raptortest/IoT-Water-Monitoring/3 picture/32.jpg

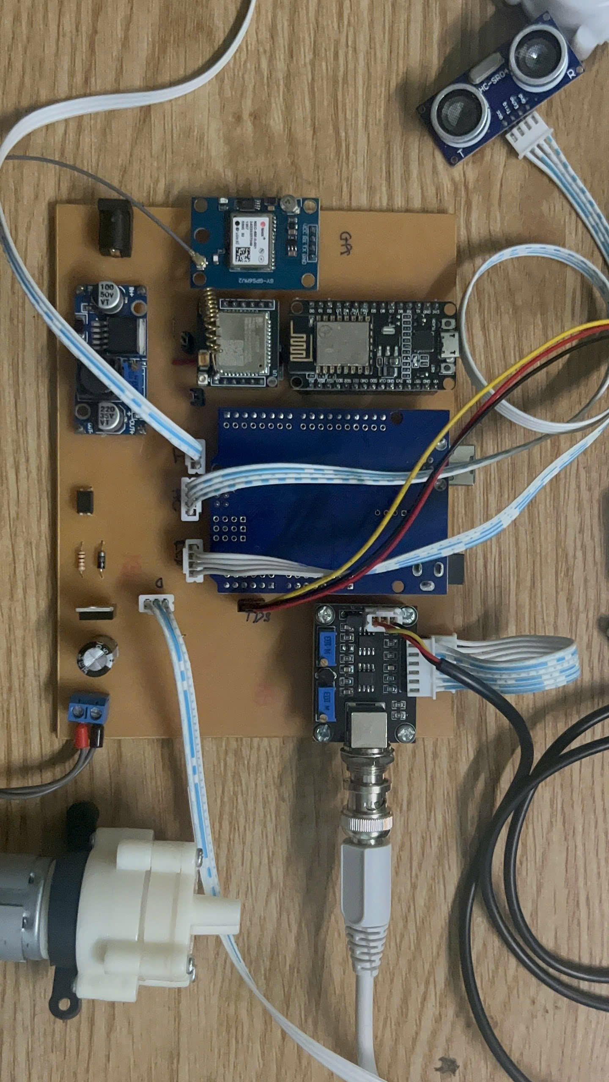
3 picture/32.jpg
