raptortest/IoT-Water-Monitoring/3 picture/54.jpg

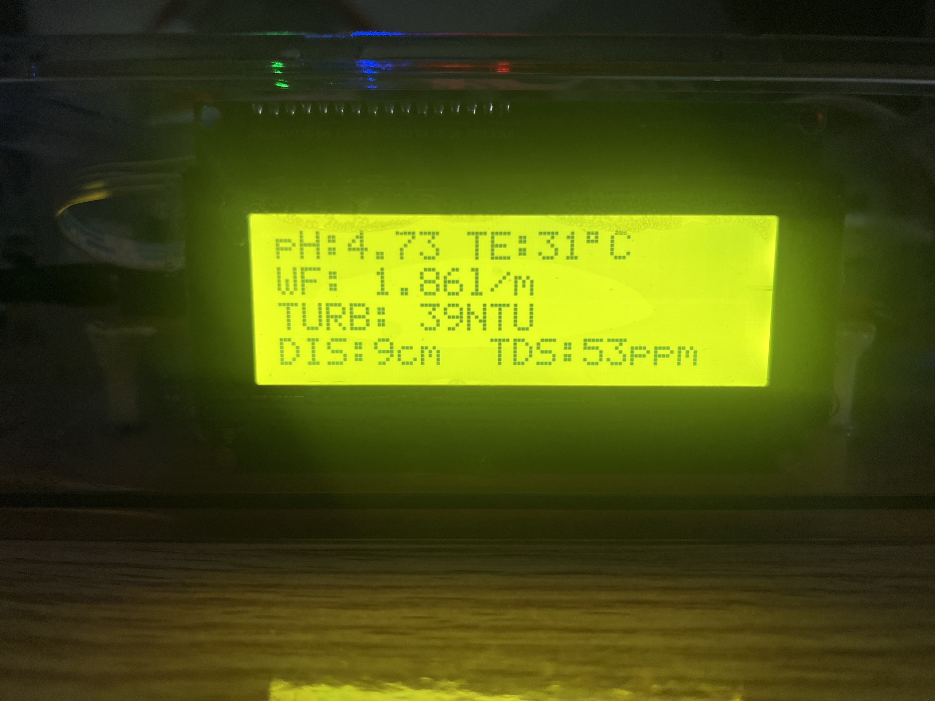
3 picture/54.jpg
