raptortest/IoT-Water-Monitoring/README.md

# 📡 IoT-Based Water Resource Monitoring System

🎓 **Graduation Thesis – International University - VNU HCMC**  
👨‍🎓 Student: Nguyễn Trung Tín – ID: EEACIU19063  
👨‍🏫 Advisor: Dr. Vương Quốc Bảo  
📅 Year: 2025  

---

## 📘 Overview
This project develops an IoT-based system for real-time monitoring of water quality using multiple sensors (pH, TDS, turbidity, temperature, flow, GPS) integrated with Arduino and ESP8266. It sends alerts via the Blynk app and SMS using a 4G A7682S module.

---

## 🔧 Technologies Used
- Arduino UNO, ESP8266, A7682S 4G LTE Module
- Sensors: pH, TDS, Turbidity, DS18B20 Temperature, YF-S401 Flow, GPS
- Blynk IoT Platform
- Proteus Design Suite (for circuit simulation)
- C/C++ (Arduino IDE)

---

## 📂 Folder Structure
- `/code`: Arduino and ESP code
- `/thesis`: Thesis report and presentation
- `/images`: Prototype photos, LCD outputs, Blynk screenshots
- `/proteus`: Circuit simulation files
- `/data`: Sensor calibration and test data

---

## 📲 Features
- Real-time monitoring via Blynk app
- SMS alerts when thresholds exceeded
- Location tracking via GPS
- Flow rate calculation and pH adjustment logic
- Proteus circuit simulation provided

---

## 📸 Screenshots

---

## 🧪 Results
The system has been tested in various water conditions (acidic, neutral, alkaline), showing reliable and accurate sensor readings with timely alerts.

---

## 📈 Future Improvements
- Integrate AI to classify water quality (clean vs polluted)
- Improve sensor calibration accuracy
- Add solar power module for remote deployment

---

## 📜 License
This project is licensed under the MIT License.
