raptortest/IoT-Water-Monitoring/3 picture/1.jpg

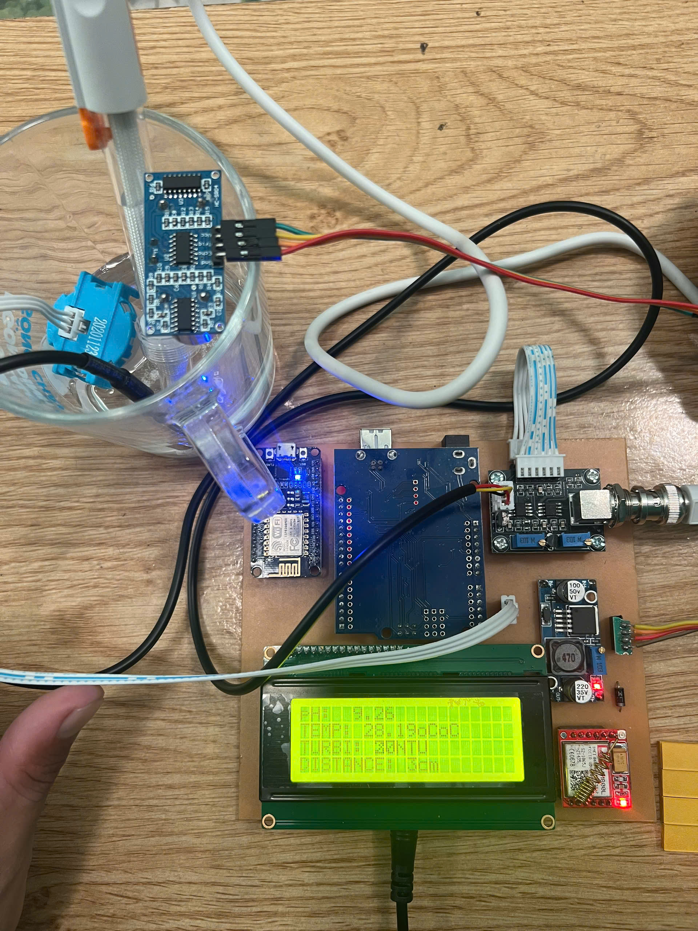
3 picture/1.jpg
