raptortest/IoT-Water-Monitoring/3 picture/2.jpg

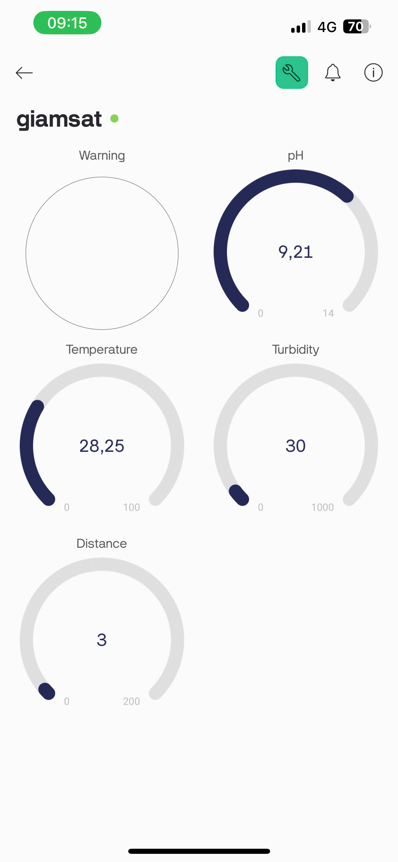
3 picture/2.jpg
