raptortest/IoT-Water-Monitoring/3 picture/3.jpg

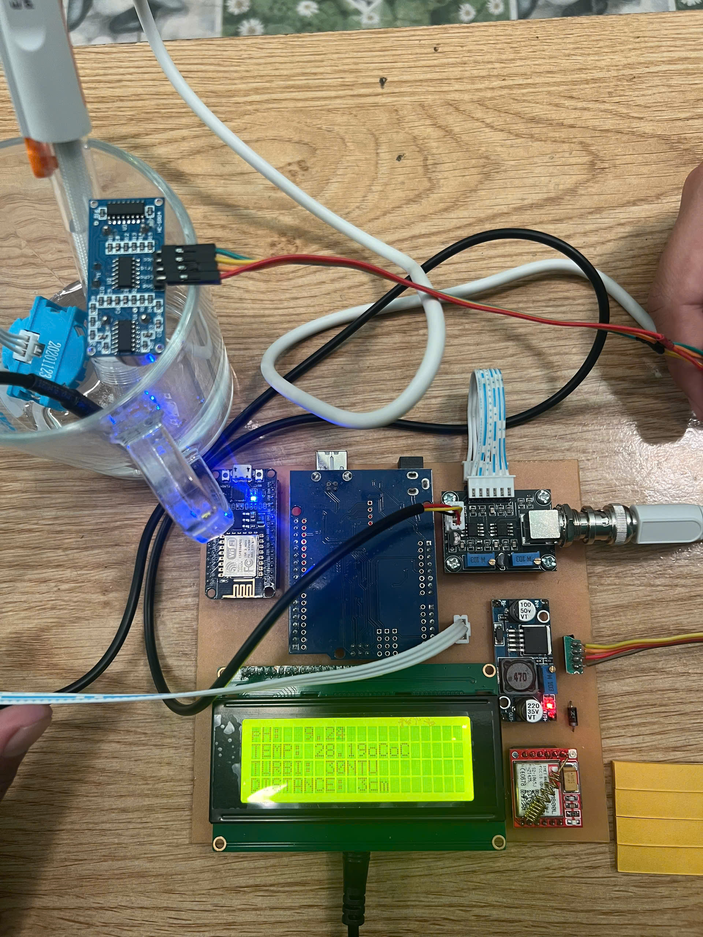
3 picture/3.jpg
