raptortest/IoT-Water-Monitoring/3 picture/4.jpg

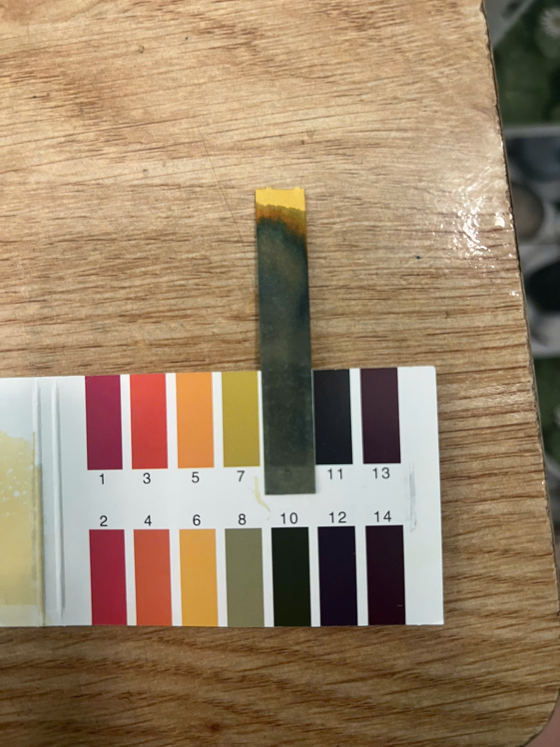
3 picture/4.jpg
