raptortest/IoT-Water-Monitoring/3 picture/5.jpg

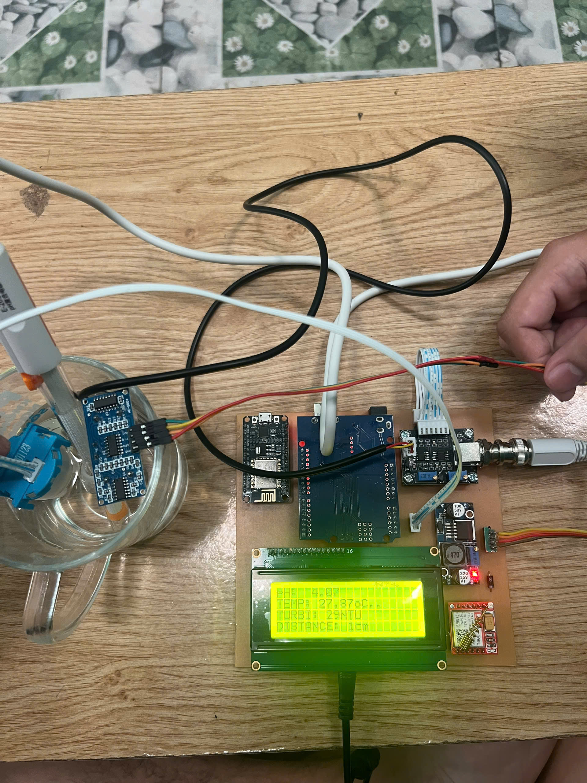
3 picture/5.jpg
