raptortest/IoT-Water-Monitoring/3 picture/6.jpg

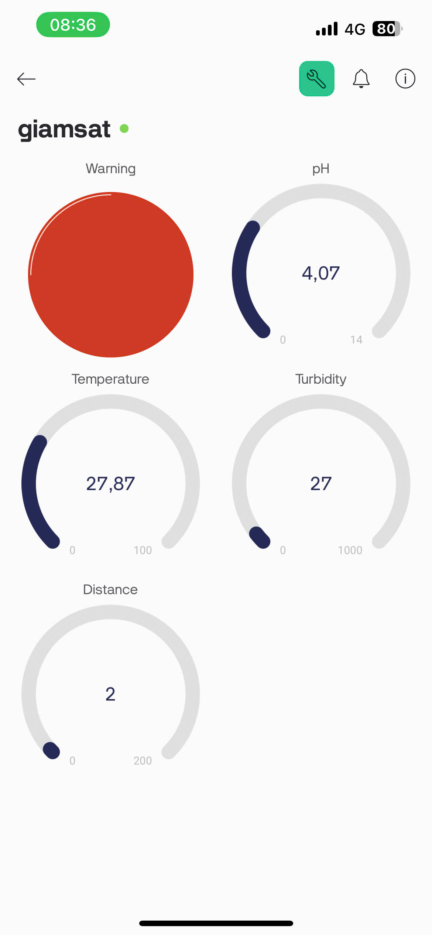
3 picture/6.jpg
