raptortest/IoT-Water-Monitoring/3 picture/7.jpg

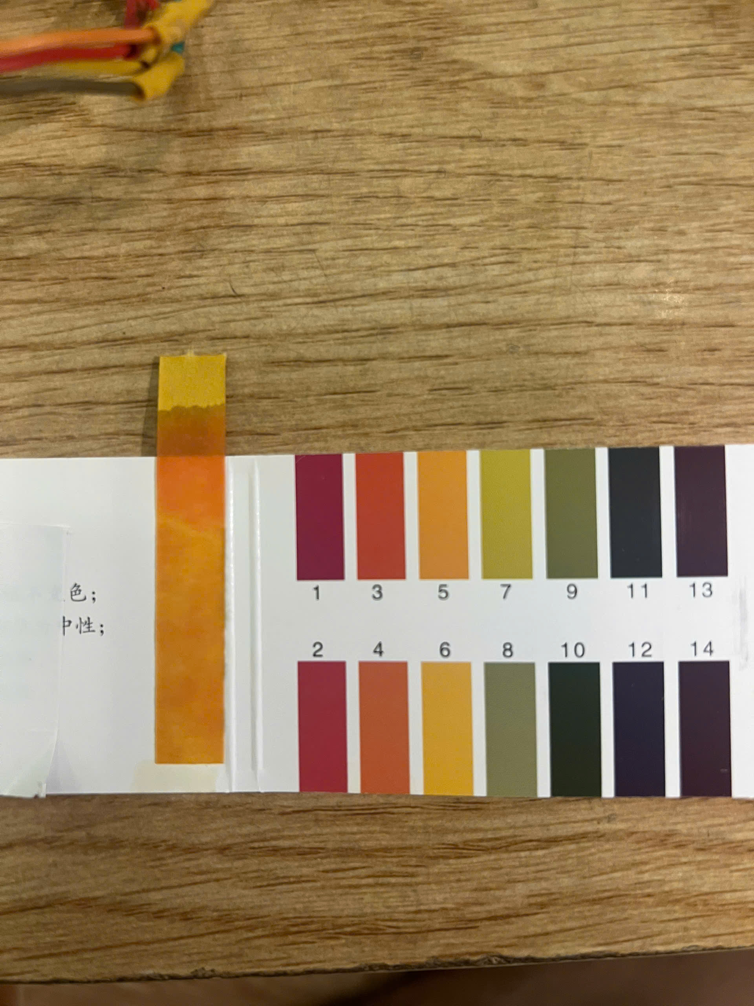
3 picture/7.jpg
