raptortest/IoT-Water-Monitoring/3 picture/8.jpg

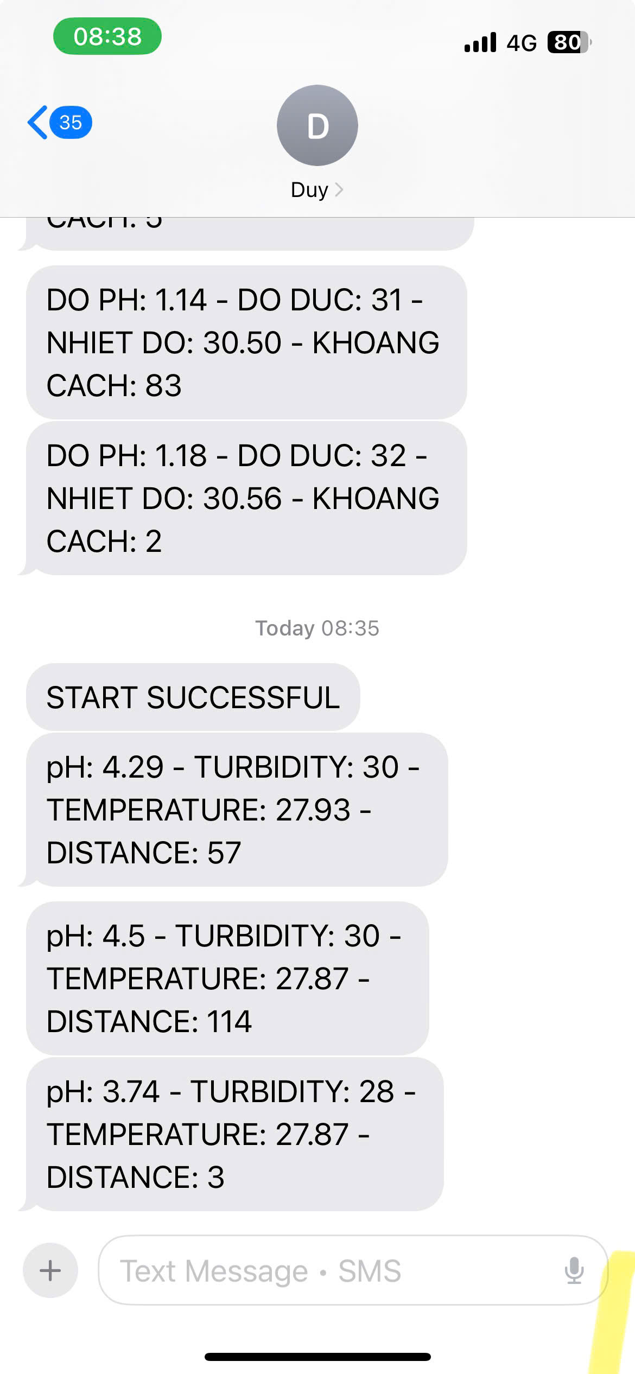
3 picture/8.jpg
