raptortest/IoT-Water-Monitoring/3 picture/9.jpg

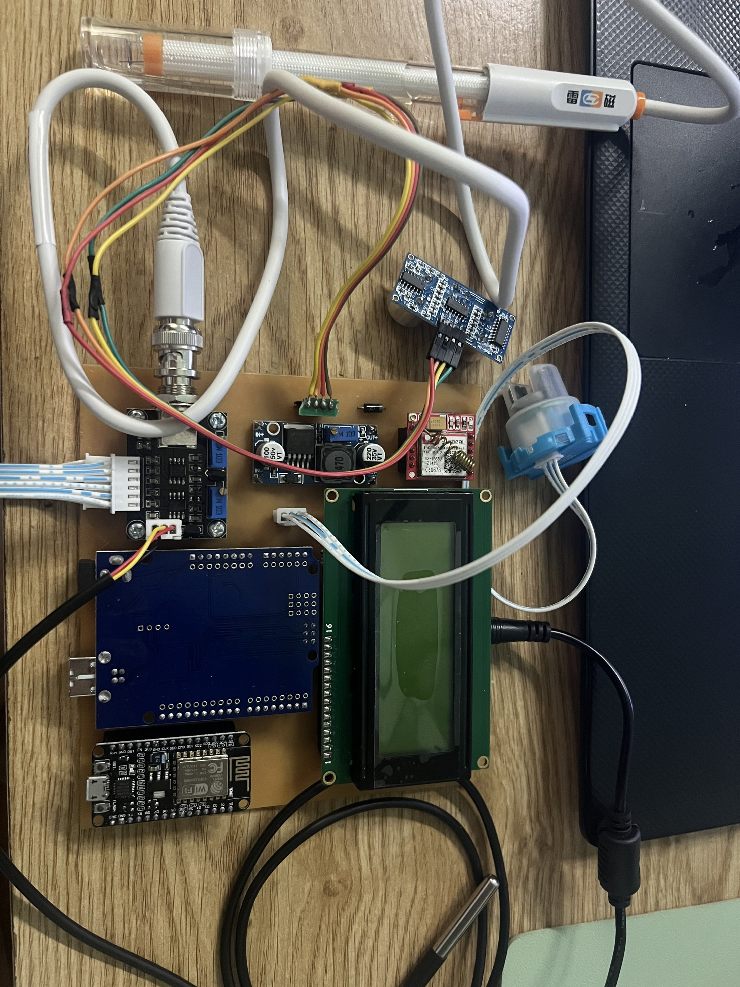
3 picture/9.jpg
