raptortest/IoT-Water-Monitoring/3 picture/10.jpg

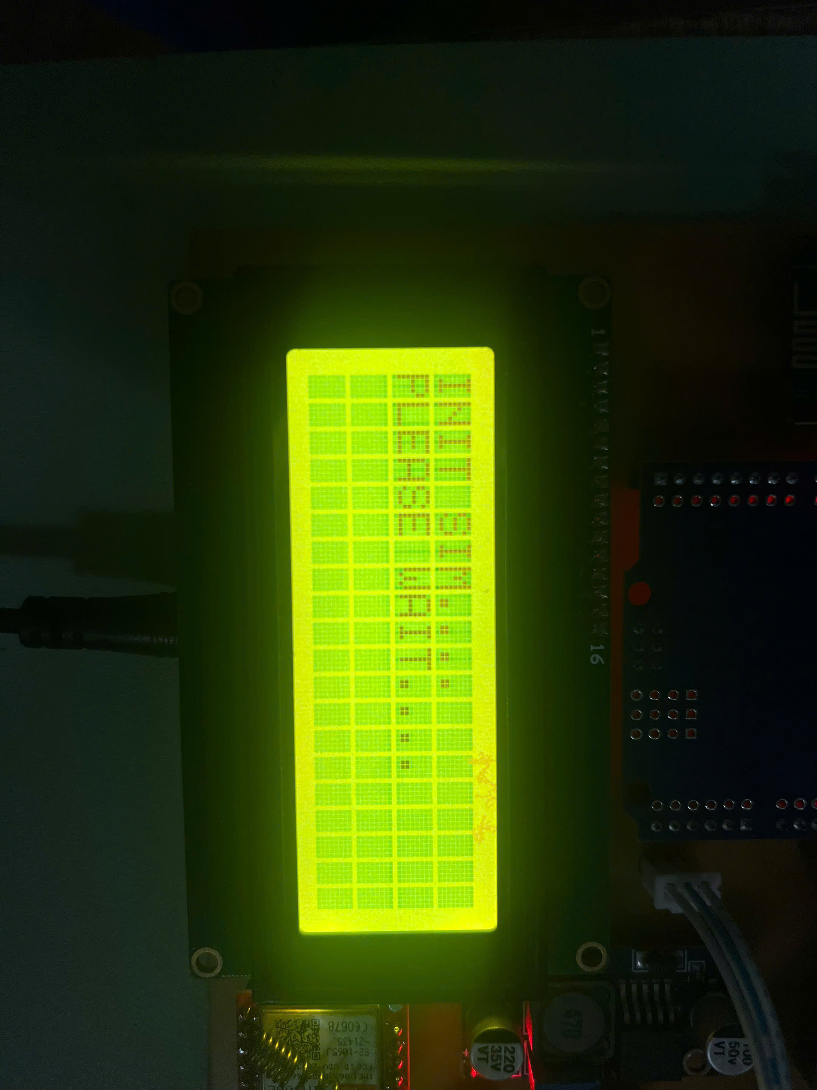
3 picture/10.jpg
