raptortest/IoT-Water-Monitoring/3 picture/12.jpg

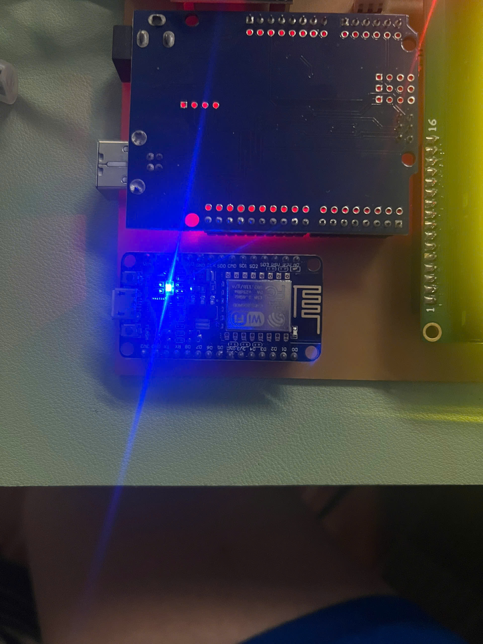
3 picture/12.jpg
