raptortest/IoT-Water-Monitoring/3 picture/13.jpg

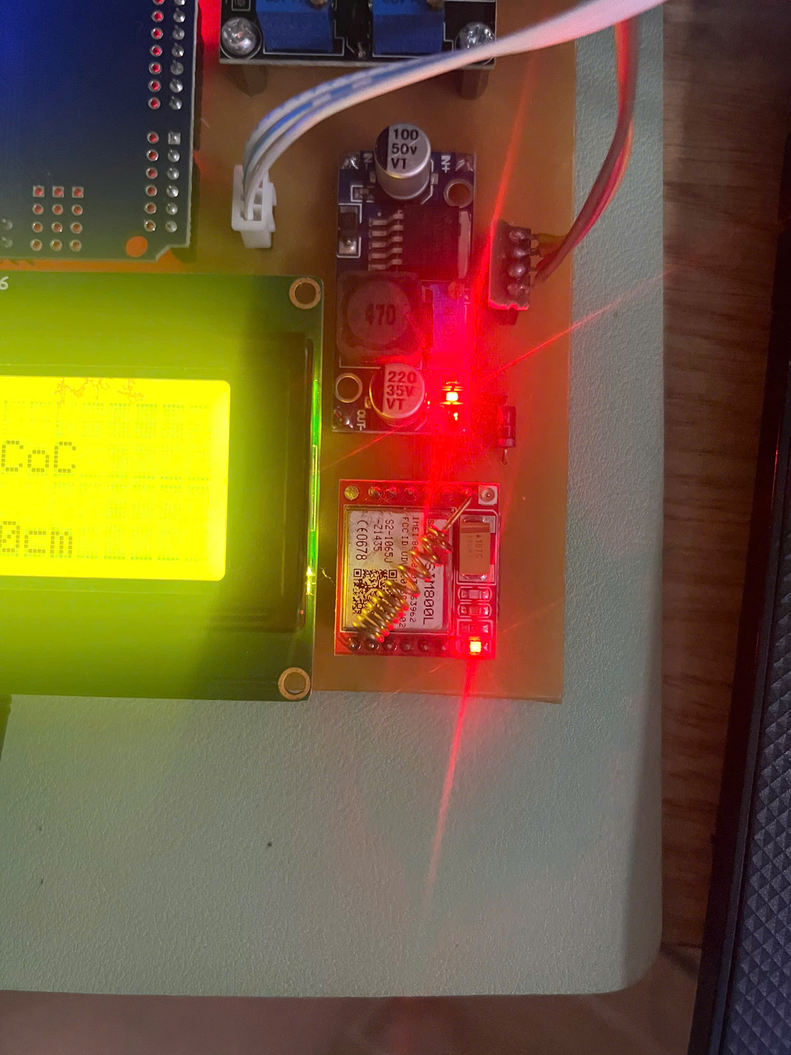
3 picture/13.jpg
