raptortest/IoT-Water-Monitoring/3 picture/15.jpg

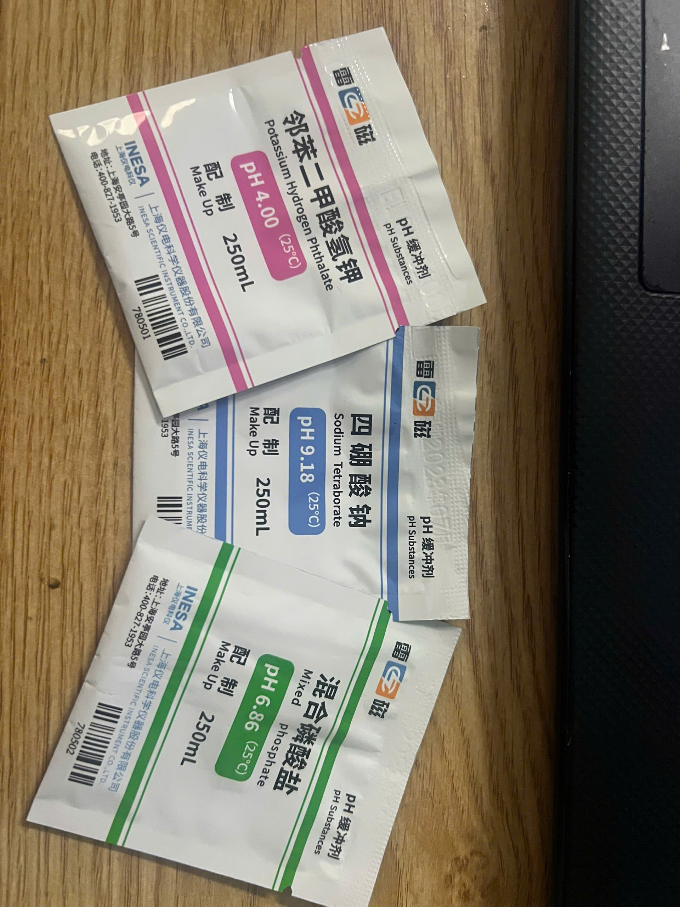
3 picture/15.jpg
