raptortest/IoT-Water-Monitoring/3 picture/19.jpg

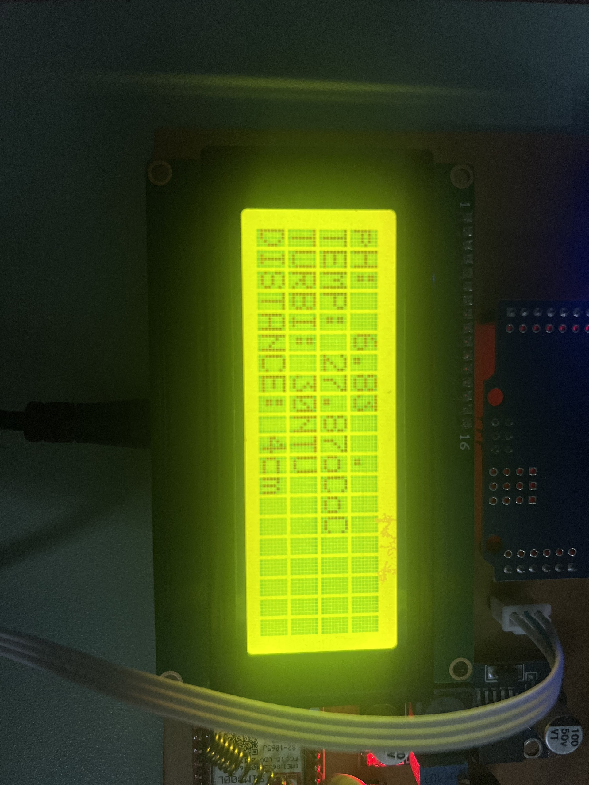
3 picture/19.jpg
