raptortest/IoT-Water-Monitoring/3 picture/21.jpg

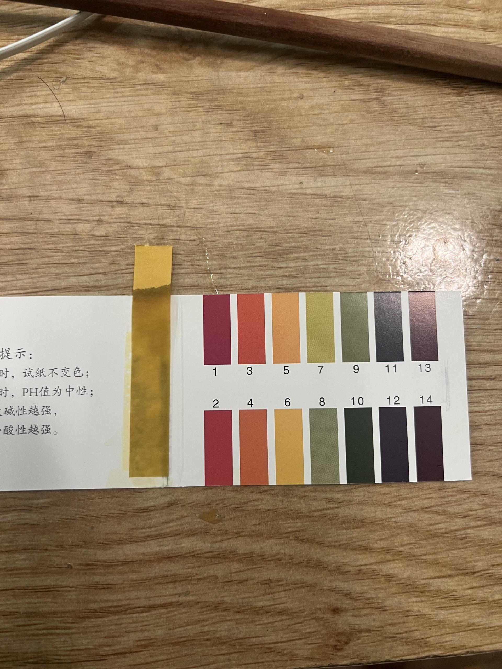
3 picture/21.jpg
