raptortest/IoT-Water-Monitoring/3 picture/24.jpg

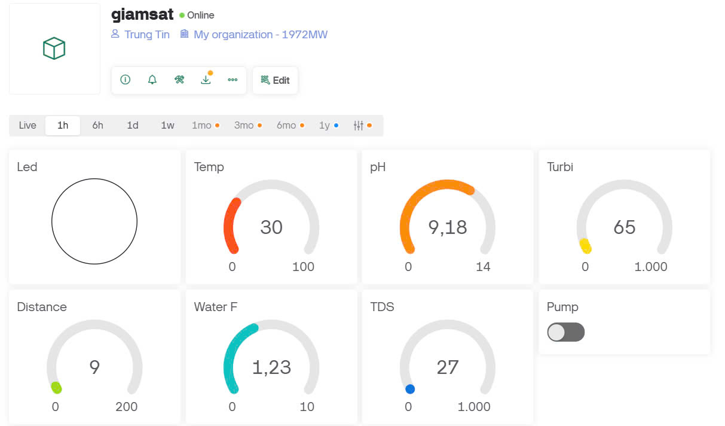
3 picture/24.jpg
