raptortest/IoT-Water-Monitoring/3 picture/25.jpg

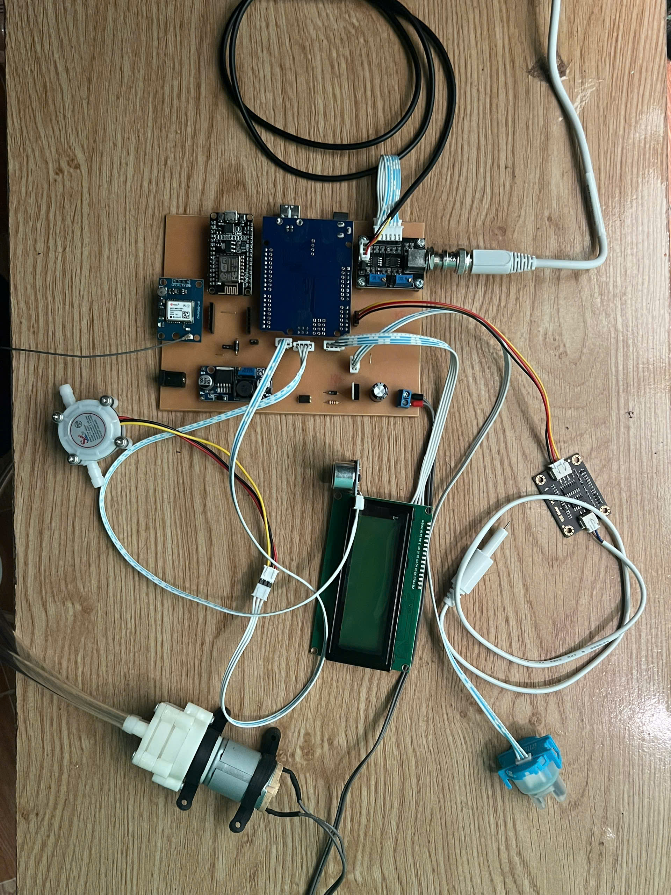
3 picture/25.jpg
