raptortest/IoT-Water-Monitoring/3 picture/26.jpg

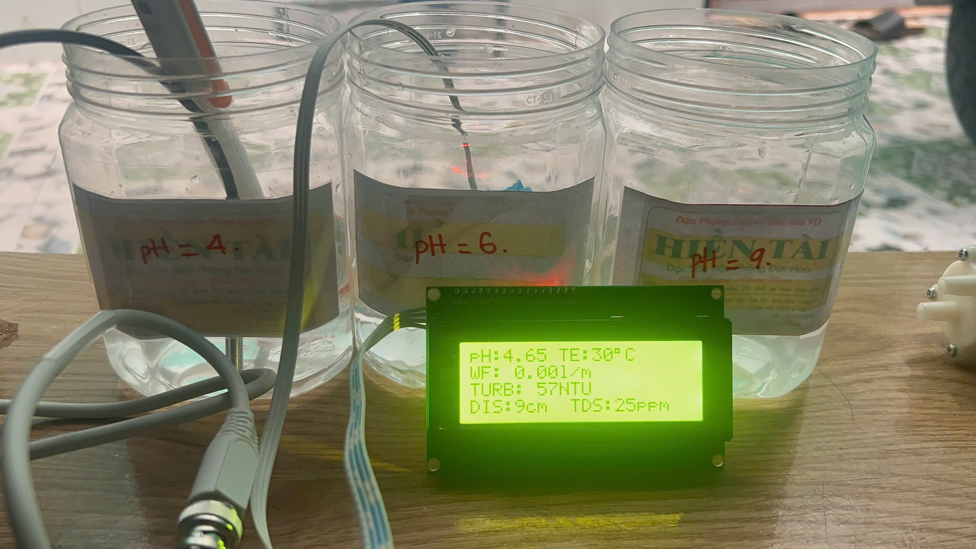
3 picture/26.jpg
