raptortest/IoT-Water-Monitoring/3 picture/27.jpg

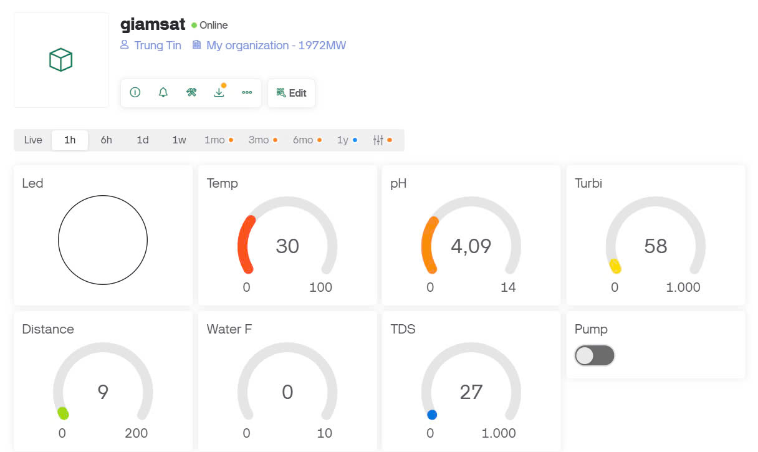
3 picture/27.jpg
