raptortest/IoT-Water-Monitoring/3 picture/29.jpg

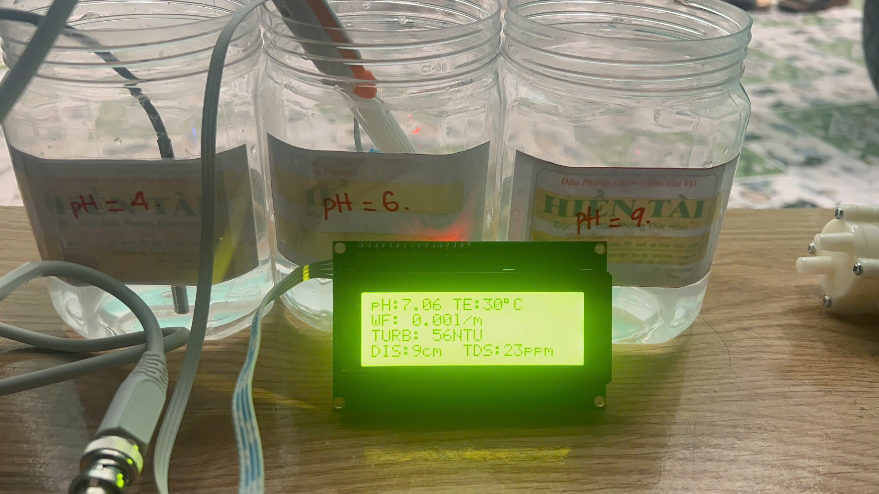
3 picture/29.jpg
