raptortest/IoT-Water-Monitoring/3 picture/30.jpg

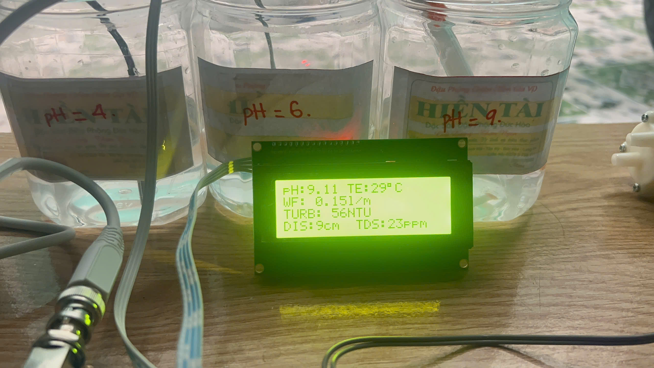
3 picture/30.jpg
