raptortest/IoT-Water-Monitoring/3 picture/31.jpg

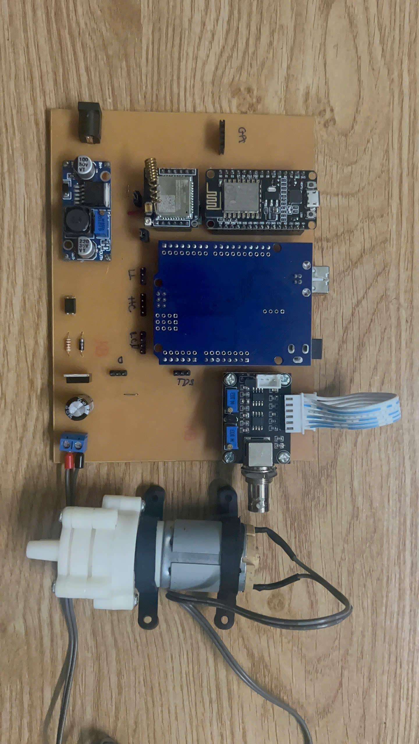
3 picture/31.jpg
