raptortest/IoT-Water-Monitoring/3 picture/33.jpg

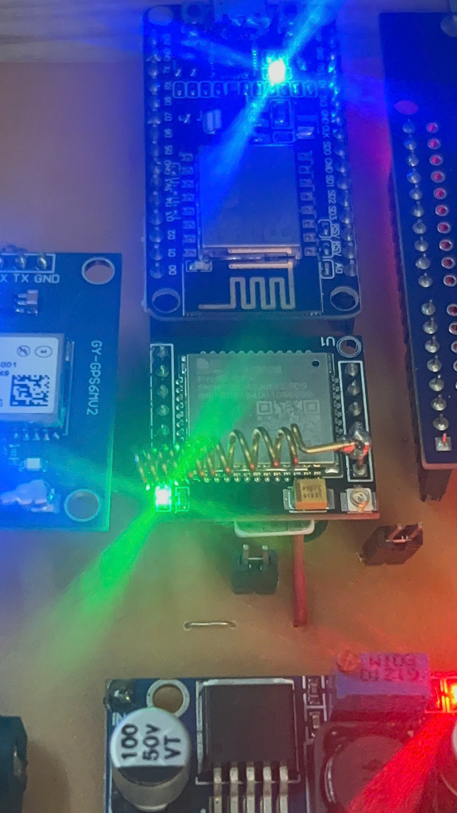
3 picture/33.jpg
