raptortest/IoT-Water-Monitoring/3 picture/34.jpg

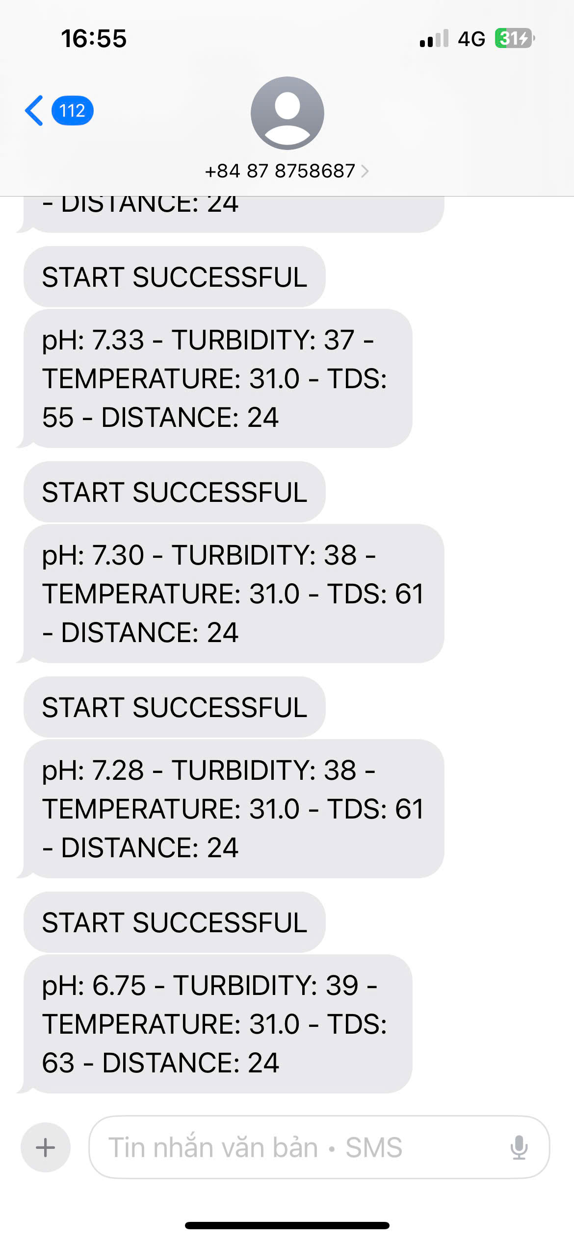
3 picture/34.jpg
