raptortest/IoT-Water-Monitoring/3 picture/35.jpg

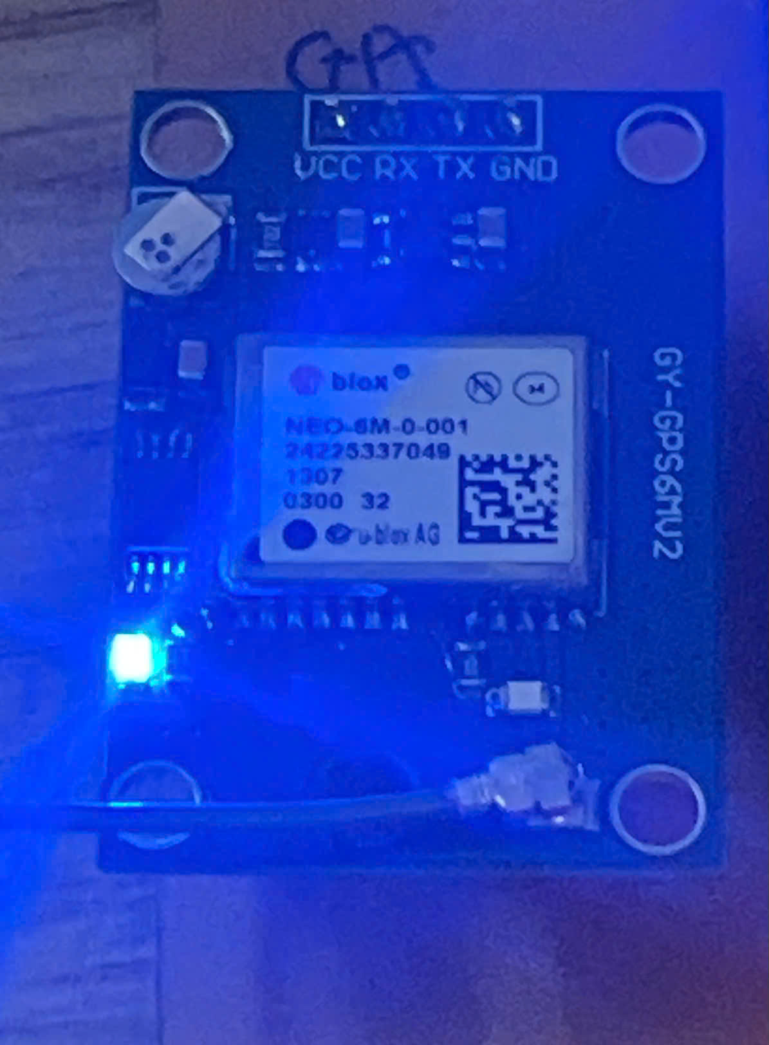
3 picture/35.jpg
