raptortest/IoT-Water-Monitoring/3 picture/36.jpg

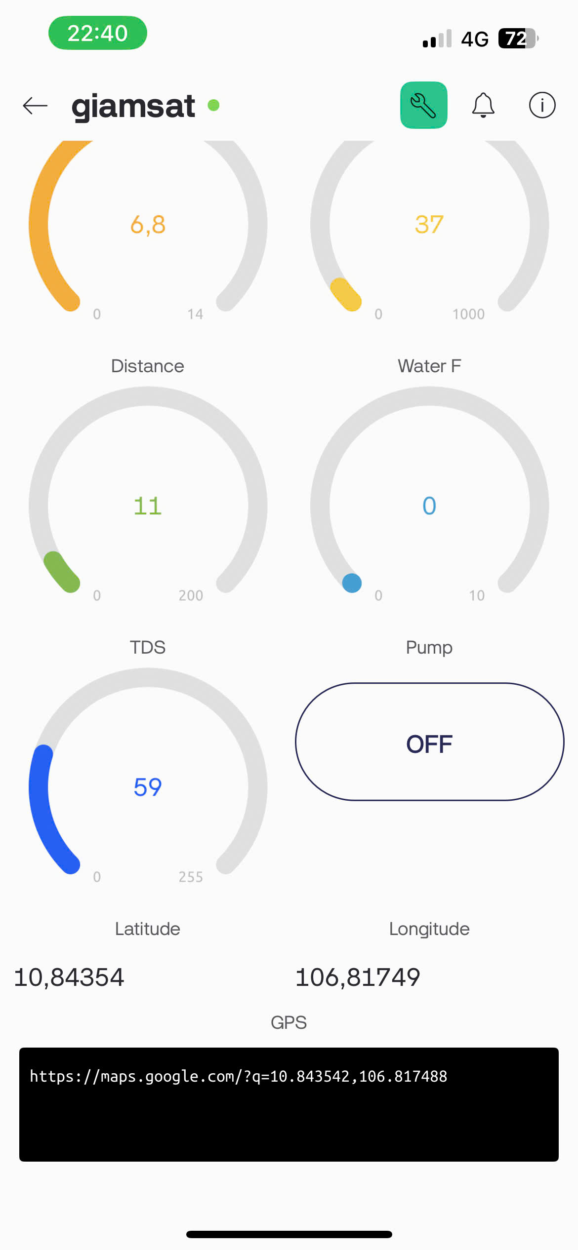
3 picture/36.jpg
