raptortest/IoT-Water-Monitoring/3 picture/37.jpg

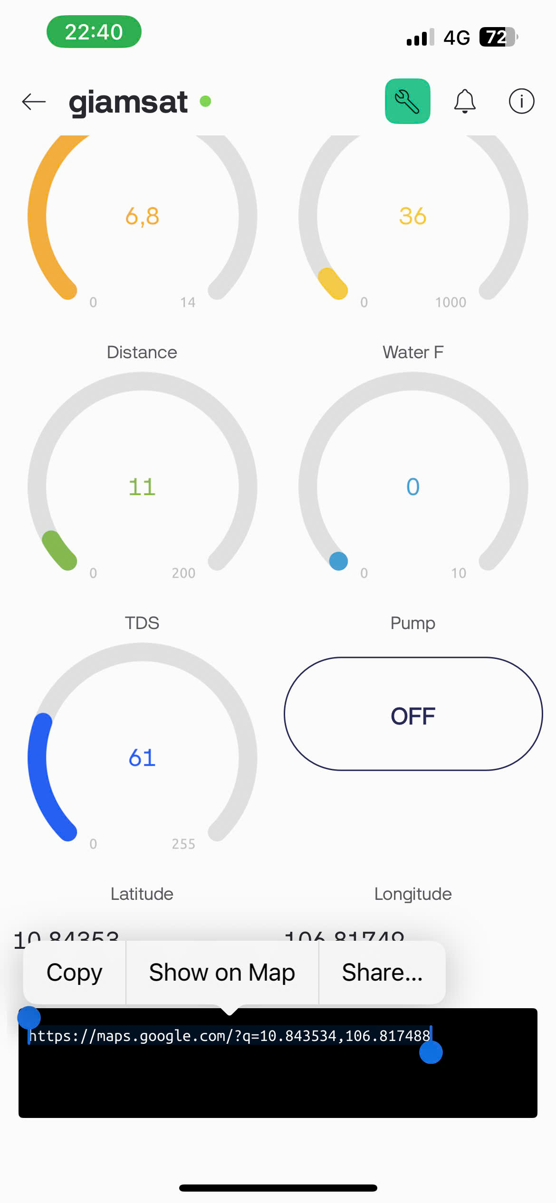
3 picture/37.jpg
