raptortest/IoT-Water-Monitoring/3 picture/38.jpg

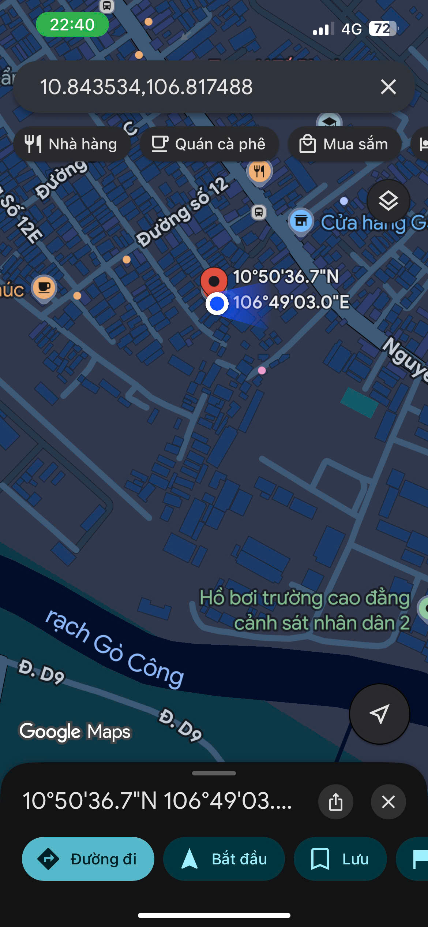
3 picture/38.jpg
