raptortest/IoT-Water-Monitoring/3 picture/40.jpg

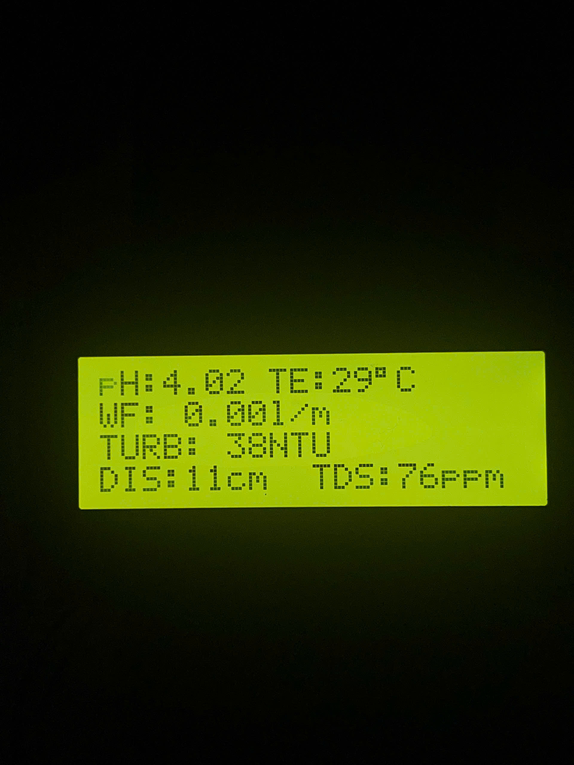
3 picture/40.jpg
