raptortest/IoT-Water-Monitoring/3 picture/41.jpg

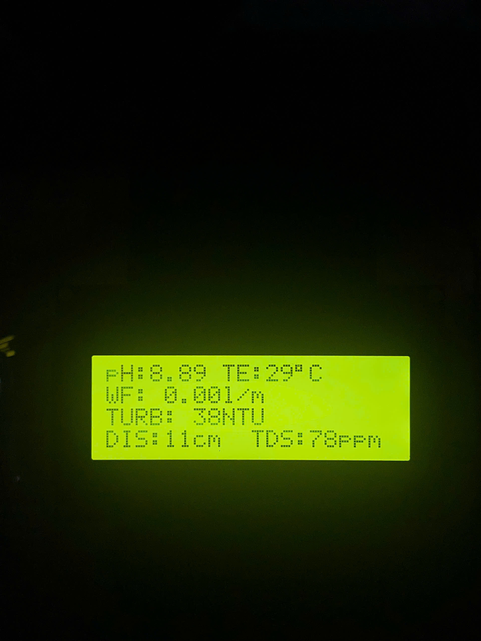
3 picture/41.jpg
