raptortest/IoT-Water-Monitoring/3 picture/42.jpg

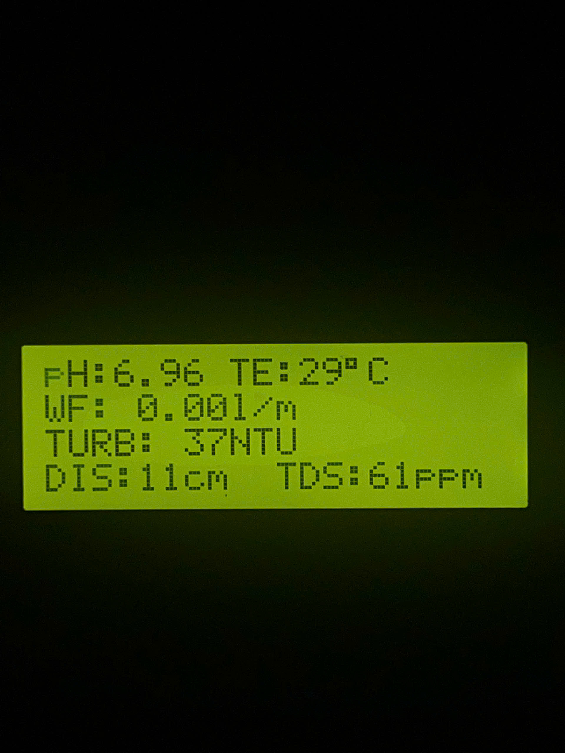
3 picture/42.jpg
