raptortest/IoT-Water-Monitoring/3 picture/43.jpg

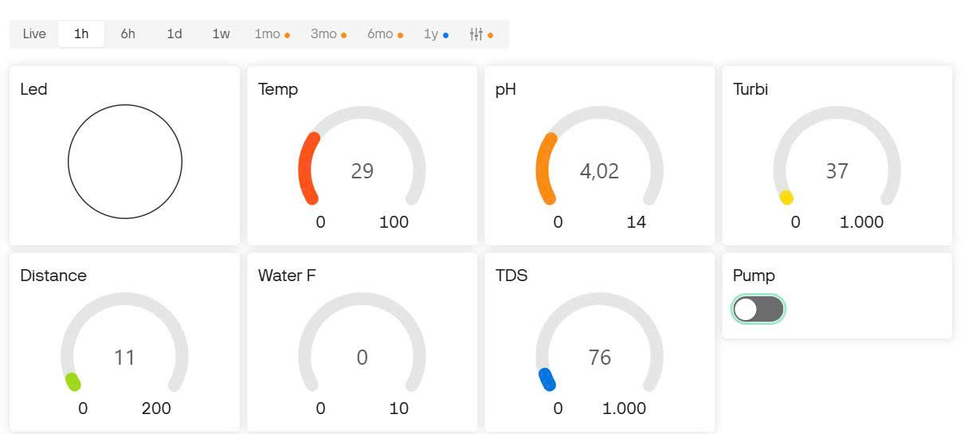
3 picture/43.jpg
