raptortest/IoT-Water-Monitoring/3 picture/46.jpg

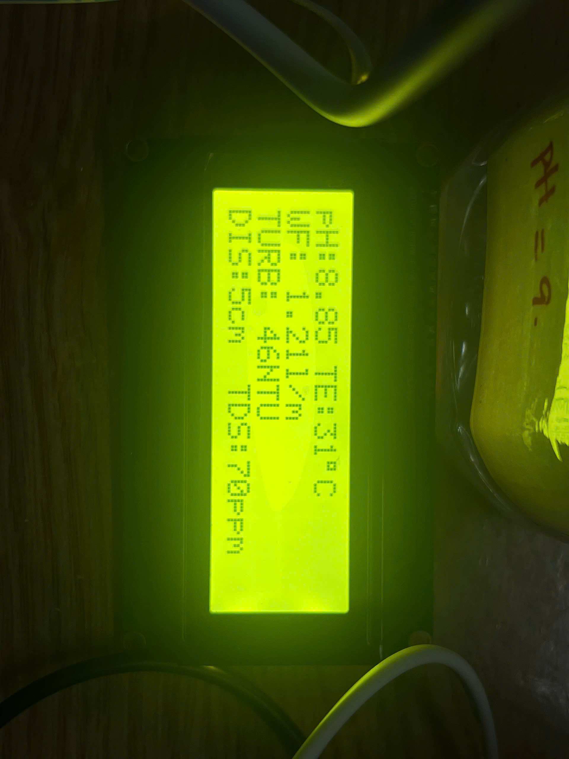
3 picture/46.jpg
