raptortest/IoT-Water-Monitoring/3 picture/48.jpg

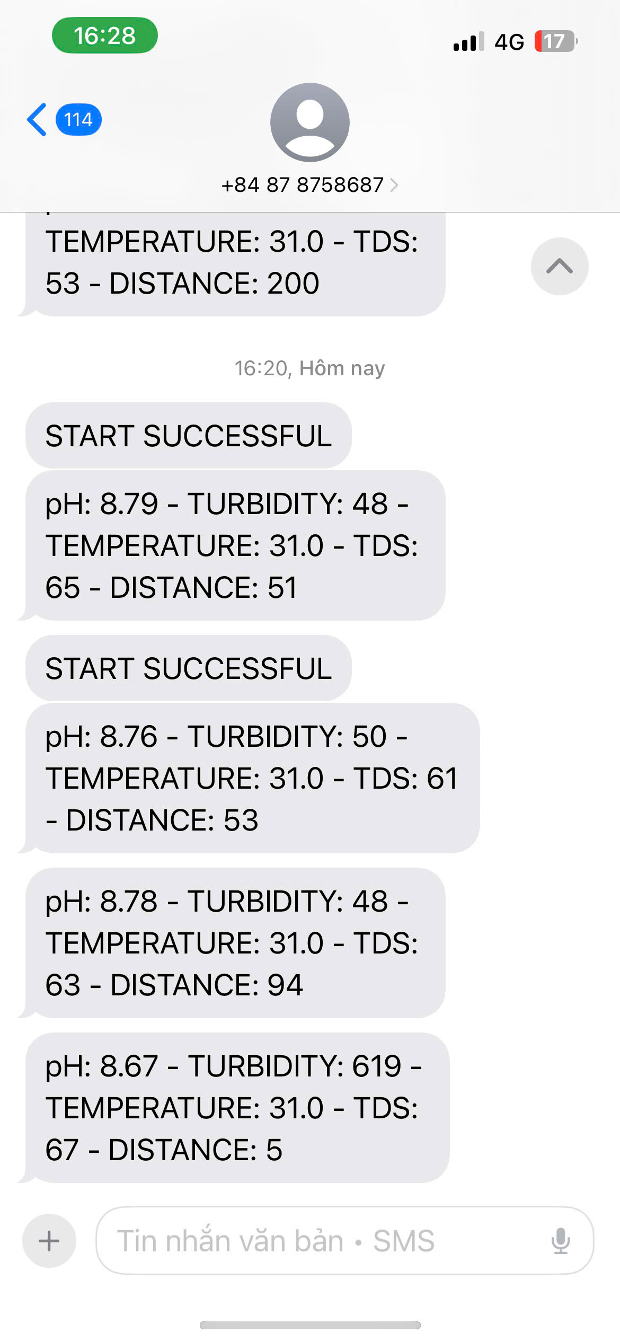
3 picture/48.jpg
