raptortest/IoT-Water-Monitoring/3 picture/51.jpg

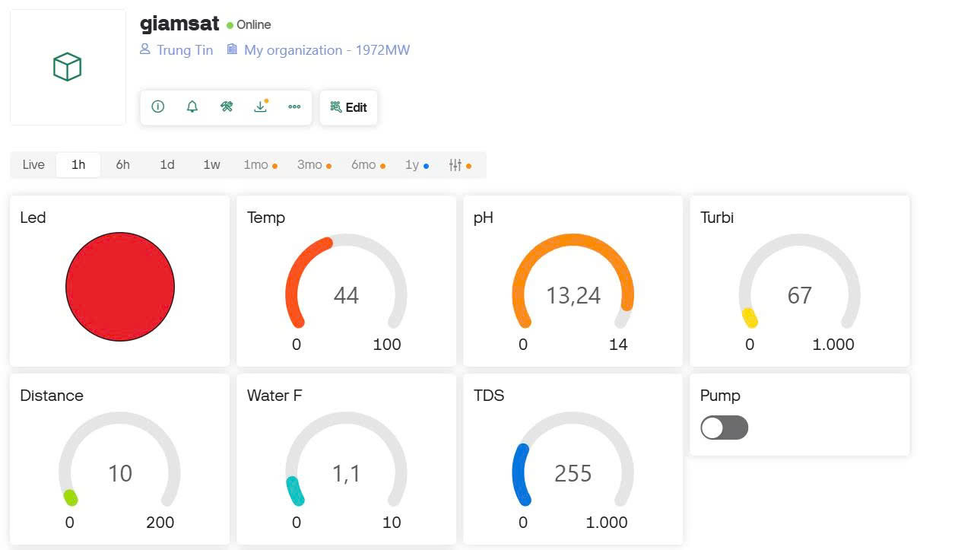
3 picture/51.jpg
