raptortest/IoT-Water-Monitoring/3 picture/52.jpg

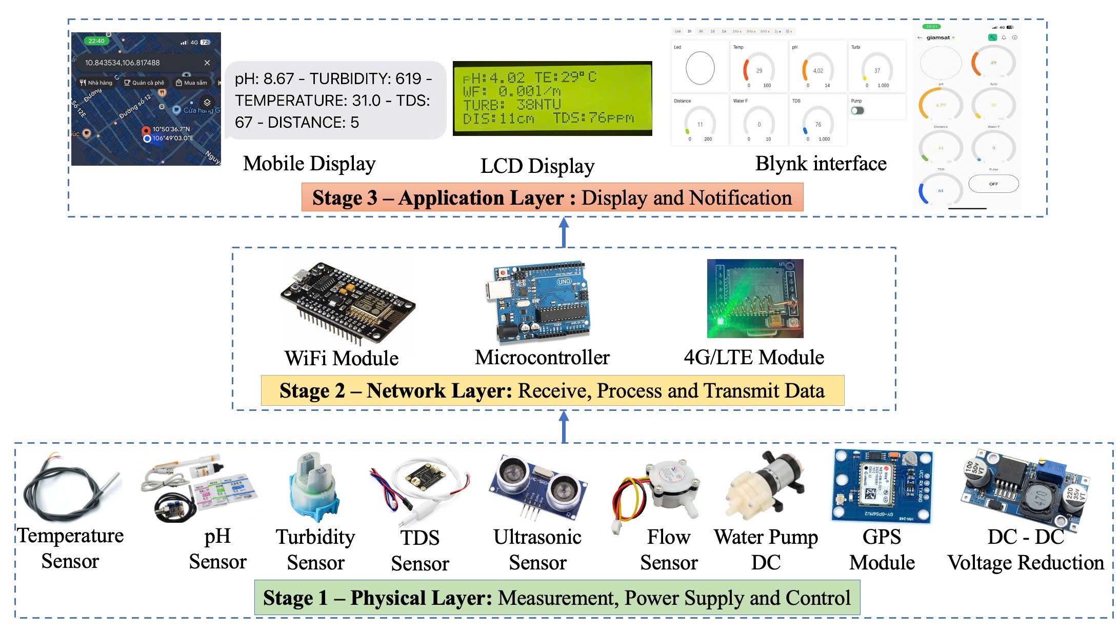
3 picture/52.jpg
