raptortest/IoT-Water-Monitoring/3 picture/53.jpg

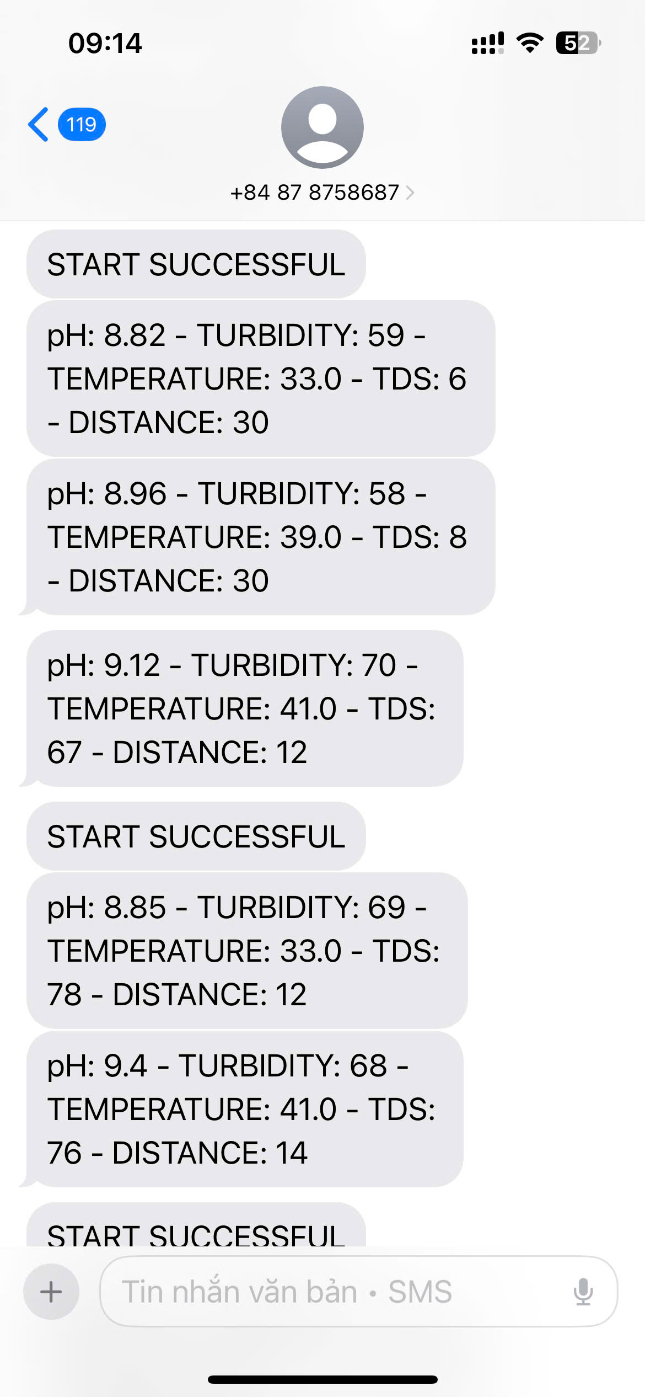
3 picture/53.jpg
