raptortest/IoT-Water-Monitoring/3 picture/55.jpg

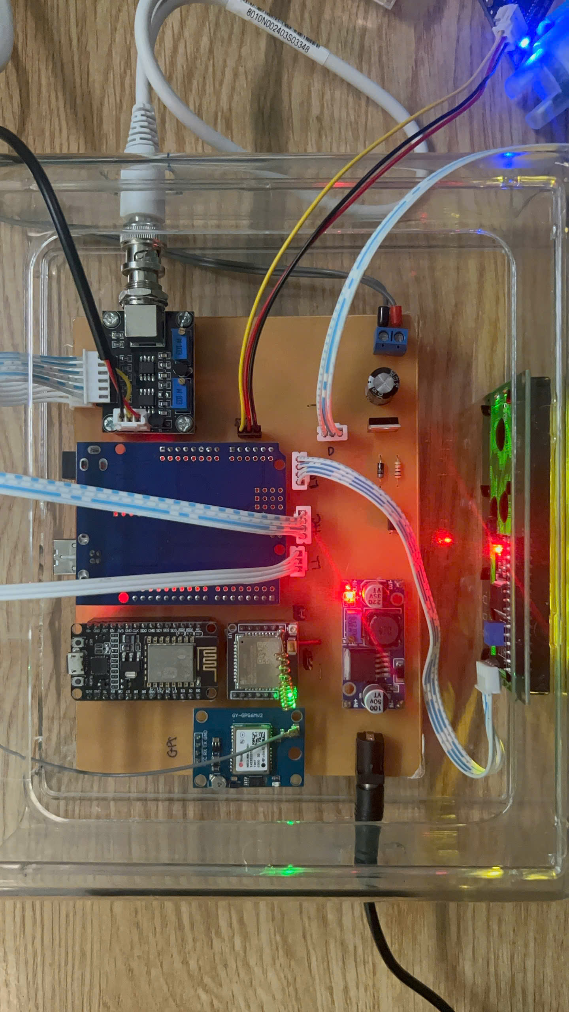
3 picture/55.jpg
