raptortest/IoT-Water-Monitoring/3 picture/56.jpg

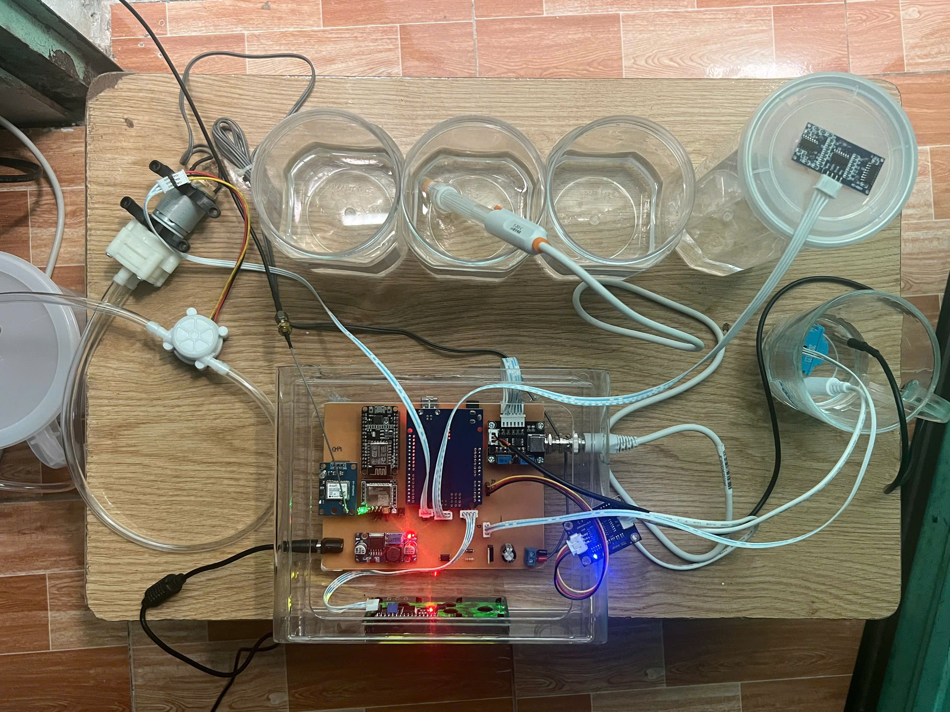
3 picture/56.jpg
