raptortest/IoT-Water-Monitoring/3 picture/57.jpg

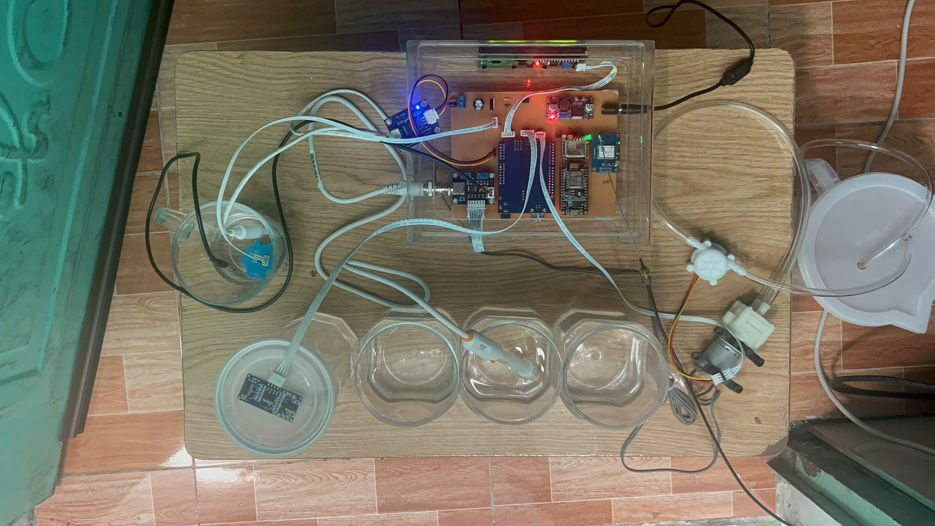
3 picture/57.jpg
