raptortest/IoT-Water-Monitoring/3 picture/58.jpg

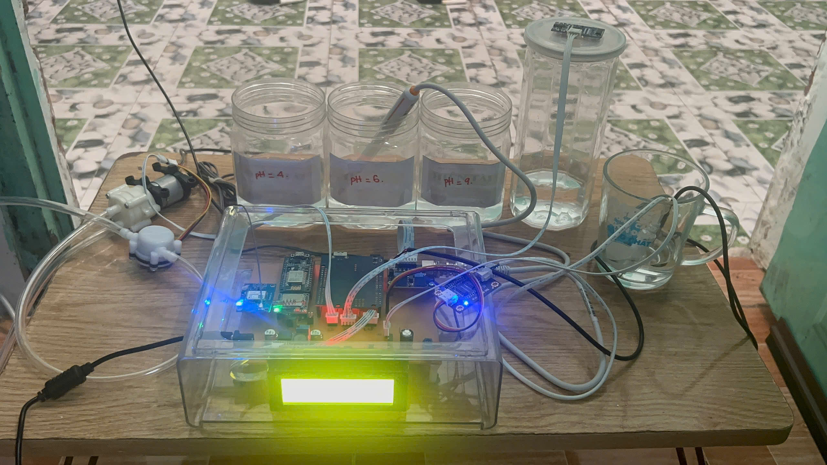
3 picture/58.jpg
