raptortest/IoT-Water-Monitoring/3 picture/59.jpg

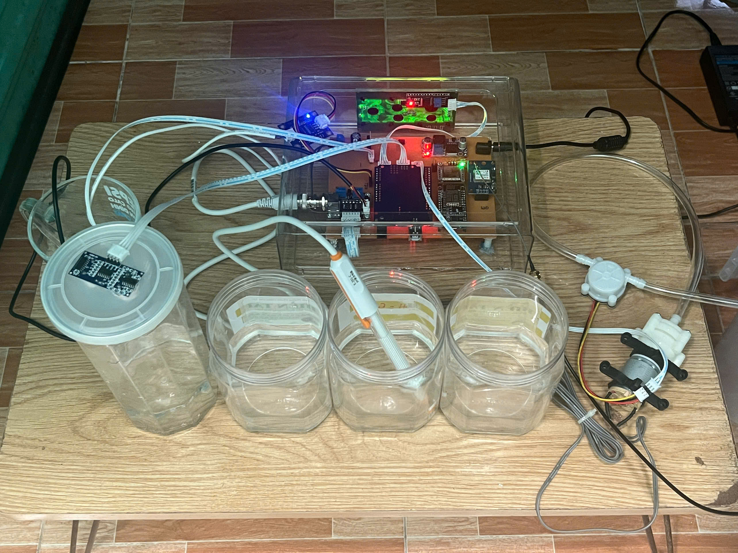
3 picture/59.jpg
