raptortest/IoT-Water-Monitoring/(list of files, drawings)

Other design files:
2 code/Mach_SRF04_ph_Duc_DS18b20_TDS_MB_LCD_GPS_CBLL_Esp_blynk_Arduino/Mach_SRF04_ph_Duc_DS18b20_TDS_MB_LCD_GPS_CBLL_Esp_blynk_Arduino.pdsprj
